mnorden81/ESP32-Sound-Mini-S3/hardware/gehaeuse/Gehaeuse3D_Vorschau.html

# Gehäuse Sound Mini S3

Entwurf 1. Unterteil und Deckel für Martins Sandwich-Aufbau: MAX98357A Rücken an Rücken unter dem ESP32-S3-Zero. Die ESP-Seite liegt oben, damit BOOT-Taste und LED am Deckel erreichbar sind. Maße aus dem 3D-Modell vom 27.10.

Außen30,0 × 26,8

Höhe18,2 mm

Modul23,5 × 19,4

Ziehen = drehen · Mausrad/zwei Finger = zoomen · rechte Maustaste = schieben

Zustand Zu Deckel ab Explosion

Ansicht Schräg USB-Seite Lautsprecher-Seite Kabel-Seite Oben Unten

Zeigen Modul Deckel Gehäuse durchsichtig

## Öffnungen

Wo | Wofür | Größe
Stirnseite | USB-C zum Flashen, Kerbe oben offen, der Deckel schließt sie | 12,8 × 6,7
Stirnseite | Kabelschlitz Port A (4 Adern zum Empfänger), Port C optional | 12,0 × 3,0
Längsseite | Lautsprecher-Stecker JST-PH 2-polig, von außen einstecken | 7,2 × 5,0
Boden | Port B (IO7/IO8): 2-pol. Dupont-Stecker von unten auf die Stifte | 8,3 × 3,0
Boden | IO5/IO6-Stifte (frei, sonst nichts) | 8,3 × 3,0
Deckel | BOOT-Taste als federnde Zunge mit Stößel (WLAN-Start) | Ø 3,6
Deckel | Fenster für die RGB-LED | Ø 2,6
Deckel | RESET mit Büroklammer | Ø 1,6

## Annahmen, bitte prüfen

- Maße aus dem 3D-Modell, nicht nachgemessen. ESP 23,5 × 18, MAX 18 × 19,4, Abstand der Platinen 2,5 mm (Kunststoff der Stiftleiste). Wenn dein MAX-Klon anders groß ist, bitte messen.
- Lage von BOOT, RESET und LED auf dem S3-Zero habe ich aus dem Foto geschätzt (BOOT und RESET 5 mm links/rechts der LED, 8,5 mm vom USB-Ende).
- Port B wird mit einem 2-poligen Dupont-Stecker von unten durch den Boden auf die Stifte gesteckt. Wenn du die Adern lieber anlötest, geht das auch.
- Port A Kabel läuft oben über den ESP zum Schlitz an der Stirnseite. Der JST-Stecker bleibt außen.
- Halt im Gehäuse: zwei Stützen unten (unter MAX und unter ESP-Ende), zwei Niederhalter am Deckel und die USB-Buchse in der Kerbe. Kein Schrauben, kein Kleben nötig.
- Deckel klemmt mit einer Lippe und zwei kleinen Rastnasen. Sitzt er zu stramm, Spiel TOL in gehaeuse.py von 0,15 auf 0,2 erhöhen.

## Drucken und Montieren

- Material PLA oder PETG, 0,2 mm Schicht (für die feine Schrift 0,12 mm), 100 % bei den kleinen Wänden ist automatisch.
- Unterteil mit dem Boden aufs Bett, Deckel mit der Oberseite aufs Bett (STL ist schon gedreht). Keine Stützen nötig.
- Einbauen: Modul mit der ESP-Seite nach oben einlegen, USB-C in die Kerbe, Port-A-Kabel in den Schlitz legen, Deckel aufdrücken.
- Lautsprecher von außen einstecken, Port B von unten.
- Im Modell: 2 Laschen mit 2,4-mm-Loch (M2 oder Kabelbinder) oder doppelseitiges Klebeband unter den Boden.
- Wand 1,6 mm, Boden und Deckel 1,6 mm.

## Dateien

- Gehaeuse_Unterteil.stl / .step
- Gehaeuse_Deckel.stl / .step
- gehaeuse.py (Quelle, CadQuery, alle Maße als Parameter oben in der Datei)

STEP lässt sich in Fusion 360 oder FreeCAD öffnen und weiter ändern. Kollisionsprüfung Modul gegen Gehäuse: 0 mm³.
