mnorden81/ESP32-Sound-Mini-S3/hardware/gehaeuse/Gehaeuse_Deckel.step

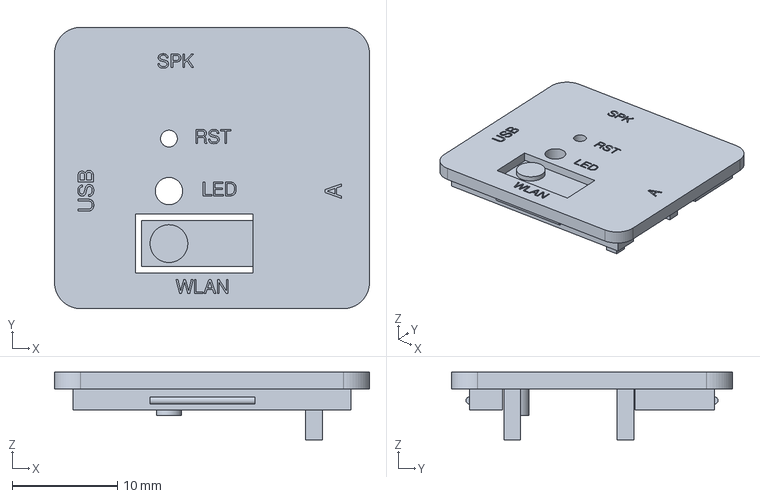
[picture p11: CAD file, 2026-10-29]
hardware/gehaeuse/Gehaeuse_Deckel.step
30.0 x 26.8 x 6.45 mm
