mnorden81/ESP32-Sound-Mini-S3/hardware/gehaeuse/Gehaeuse_Unterteil.step

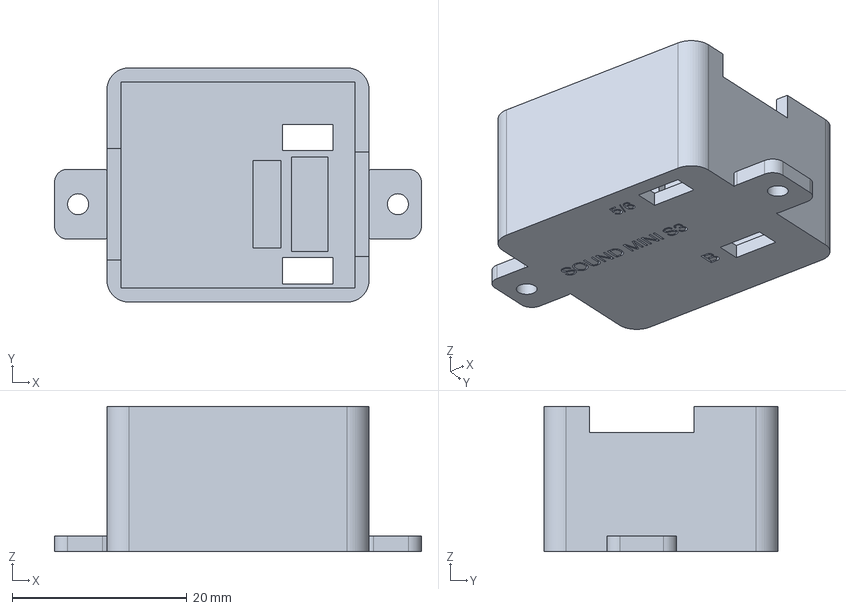
[picture p12: CAD file, 2026-10-29]
hardware/gehaeuse/Gehaeuse_Unterteil.step
42.0 x 26.8 x 16.6 mm
