mnorden81/ESP32-Sound-Mini-S3/(list of files, cad)

Other CAD files:
hardware/gehaeuse/Gehaeuse_Deckel.stl
hardware/gehaeuse/Gehaeuse_Unterteil.stl
