mnorden81/ESP32-Sound-Mini-S3/docs/3d-modell/Aufbau3D_Mini-S3.html

Soundmodul Mini S3 · Aufbau

# ESP32-S3-Zero und MAX98357A als Sandwich

Der Verstärker sitzt Rücken an Rücken auf dem ESP. Seine 7-polige Stiftleiste geht durch beide Platinen und trifft 5V, GND, 3V3, IO1 bis IO4. Port A kommt als 4-adriges Kabel mit JST-Stecker, Port B als zwei Stifte.

ziehen = drehen · Rad = zoomen

Ansicht

MAX-Seite ESP-Seite Draufsicht Seitenansicht

Beschriftung aus

## Was wo angelötet ist

ESP-Pin | Anschluss | Hinweis
5V | MAX VIN · Kabel rot | +5 V vom Empfänger
GND | MAX GND · Kabel schwarz
3V3 | frei | SD-Stift des MAX weggelassen
IO1 | MAX GAIN | offen = 9 dB
IO2 | MAX DIN | I2S Daten
IO3 | MAX BCLK | I2S Takt
IO4 | MAX LRC | I2S Wortauswahl
IO5 | Port A · Kabel gelb | CRSF RX ← Empfänger-TX
IO6 | Port A · Kabel weiß | CRSF TX → Empfänger-RX
IO7 / IO8 | Port B · 2 Stifte | RX / TX
IO43 / IO44 | Port C · Kabel grün / blau | optional, im Modell halb durchsichtig: direkt an die Pins löten

## Eckdaten

- Größe ca. 23,5 × 19,5 × 9 mm ohne Kabel
- BOOT-Taste liegt frei auf der ESP-Seite und dient als WLAN-Taste
- USB-C bleibt zugänglich, steht unter dem MAX hervor
- Lautsprecher am JST-PH-Stecker des MAX, nie an GND
- Keine Lochrasterplatine, kein Elko, keine SD-Karte

Modell nach Martins Fotos vom 27.10.2026 (Kabelfarben nach Standard). Kleine Bauteile sind vereinfacht, die Maße der Platinen und das Pinraster (2,54 mm) stimmen.
