mnorden81/ESP32-Sound-Mini-S3/(commit log)

2026-10-27 Doku: Sandwich-Aufbau mit 3D-Ansichten und Fotos
    Der echte Aufbau (Martin, laeuft) ist ein Sandwich: MAX98357A Ruecken an
    Ruecken auf dem ESP32-S3-Zero, kein Lochraster. README, Hardware-Bauplan
    und Projektbeschreibung darauf umgestellt, 3D-Ansichten und Fotos ergaenzt,
    Port-A-Kabelfarben festgelegt (schwarz, rot, gelb IO5, weiss IO6), Port C
    optional. Alte WLAN-Bruecke an IO9 aus Bild 'MAX direkt' entfernt.
    Claude-Session: https://claude.ai/code/session_0118D4qqy4wNMTv6qeK7BG5d
2026-10-27 Doku: DOCX repariert (eindeutige Bild-IDs), 3D-Modell als HTML
    - Hardware-Bauplan: doppelte docPr-IDs der Bilder machten die Datei in Word kaputt
    - Projektbeschreibung: Stand 27.10.2026, Firmware v0.06
    - docs/3d-modell/Aufbau3D_Mini-S3.html: drehbares 3D-Modell
    - .gitattributes: docx/png/jpg als binaer
    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
2026-10-28 Doku: Firmware v0.06 als auf Hardware getestet
    README, Projektbeschreibung und Hardware-Bauplan auf Stand 28.10.2026.
    Projektbeschreibung ergänzt um die Speicherbelegung (v0.06), Versionszeile
    0.06, Projektstruktur Arduino-Skizze, nächste Schritte aktualisiert.
    Claude-Session: https://claude.ai/code/session_0118D4qtyVZjdZJdvELZ2F6M
2026-10-28 Gehaeuse fuer das Sound Mini S3 (STL, STEP, CadQuery-Quelle)
    3D-druckbares Gehaeuse fuer den Sandwich-Aufbau, ESP-Seite oben,
    BOOT-Taste als federnde Zunge im Deckel. Vorschau, README und
    Hinweis im Haupt-README.
    Claude-Session: https://claude.ai/code/session_0118D4qt72E6TvxWmEw36YGj
    [Gehaeuse_Deckel.step, Gehaeuse_Deckel.stl, Gehaeuse_Unterteil.step, Gehaeuse_Unterteil.stl]
2026-10-28 v0.07: Speicheranzeige im Web-Tab Debug korrigiert
    - WAV-Liste prueft, ob die Datei im Flash liegt (mit Groesse), statt
    FileOK (nur true, solange der Sound geoeffnet ist)
    - RAM-Zeile eindeutig: belegt / frei / min frei, Prozent = belegt
    - Neue Karte 'Dateien im Flash' mit allen Dateien und Summe
    Claude-Session: https://claude.ai/code/session_0118D4qtoeVKxxnxQ4SMXHAu
    [ESP32_Sound_Mini_S3.ino, WebServerManager.cpp]
2026-10-29 v0.08: Sound-Speicher-Belegung aus den Dateien berechnen
    LittleFS.usedBytes() (lfs_fs_size) ist nur eine obere Schaetzung und
    wird von esp_littlefs auf die Partitionsgroesse begrenzt; im Web stand
    so dauerhaft 100 %, obwohl 0,17 MB frei waren. Jetzt zaehlt
    soundStoreUsedBytes() die 4-KB-Bloecke aller Dateien plus Metadaten
    (opendir/stat, ohne Datei-Deskriptor). Bibliothekswert nur noch im
    Serial-Log (Start, Upload-Fehler).
    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
2026-11-14 README: Anleitung zum Flashen
    Schritt-fuer-Schritt-Anleitung fuer Martin (Arduino IDE, fertige Datei
    aus GitHub Actions, Update per WLAN). Nur README, kein Code.
    Claude-Session: https://claude.ai/code/session_0118D4qqum127kn2FfD8dkis
